Arshad856/Fully_Automatic_Composter_For_Urban_House_Holds/images/mobile_2.jpg

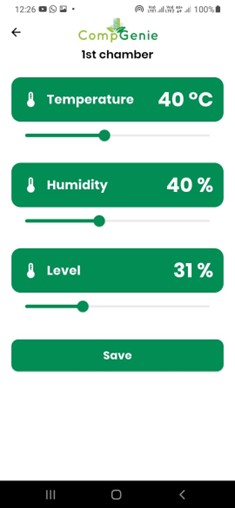
images/mobile_2.jpg
