Arshad856/Fully_Automatic_Composter_For_Urban_House_Holds/images/mobile_3.jpg

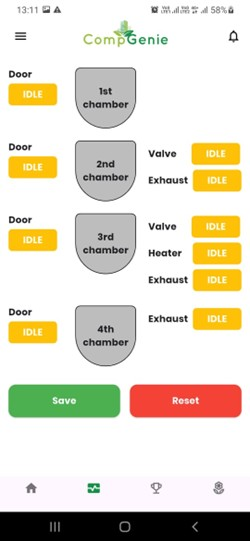
images/mobile_3.jpg
