Arshad856/Fully_Automatic_Composter_For_Urban_House_Holds/images/Picture1.png

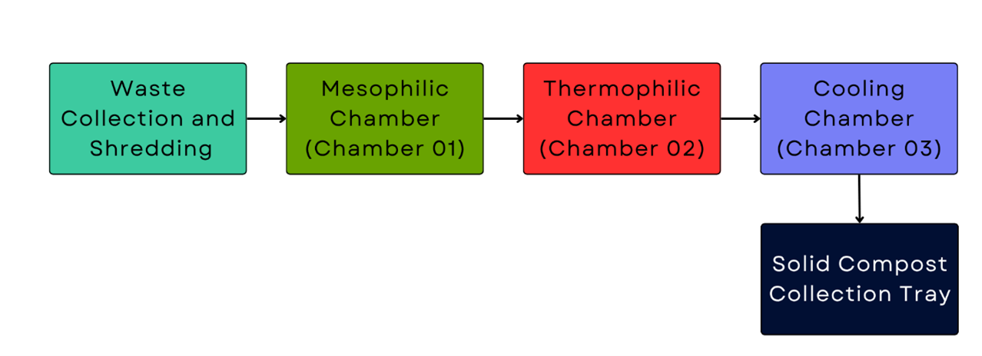
images/Picture1.png
