Arshad856/Fully_Automatic_Composter_For_Urban_House_Holds/images/temp_control.png

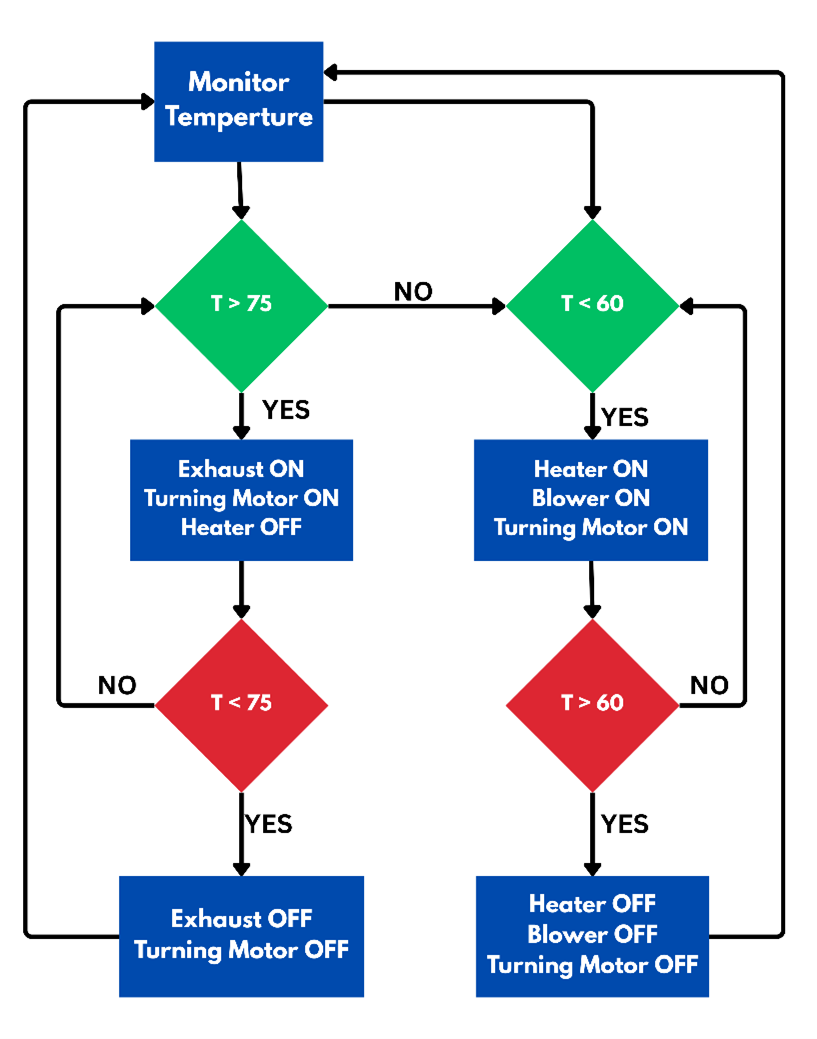
images/temp_control.png
