Arshad856/Fully_Automatic_Composter_For_Urban_House_Holds/images/turning_control.png

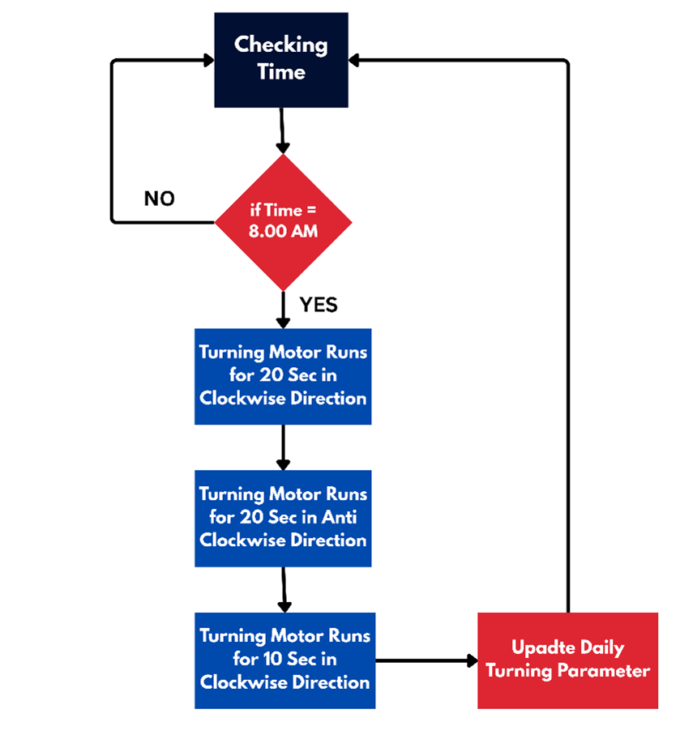
images/turning_control.png
