Arshad856/Fully_Automatic_Composter_For_Urban_House_Holds/mobile-app/mobile-app-code/assets/images/rectangle_495.png

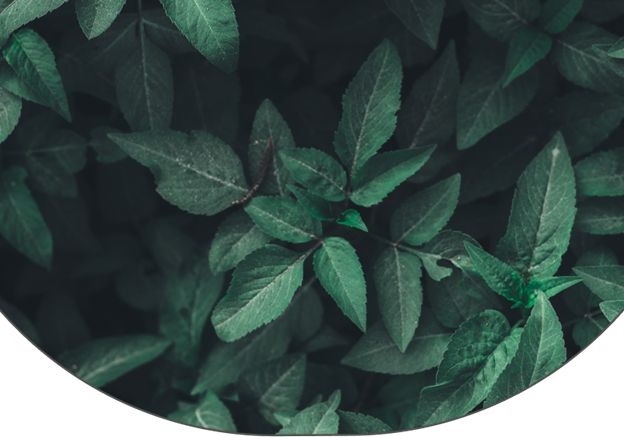
mobile-app/mobile-app-code/assets/images/rectangle_495.png
