Arshad856/Fully_Automatic_Composter_For_Urban_House_Holds/images/relay_wiring_for_bi_directional_control.png

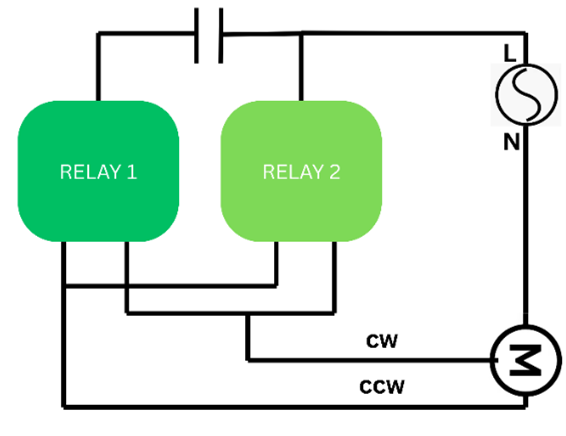
images/relay_wiring_for_bi_directional_control.png
